KrisKraa/OpenAQUA/hardware/main-controller/r2/pcb_preview/copper_top_bottom.png

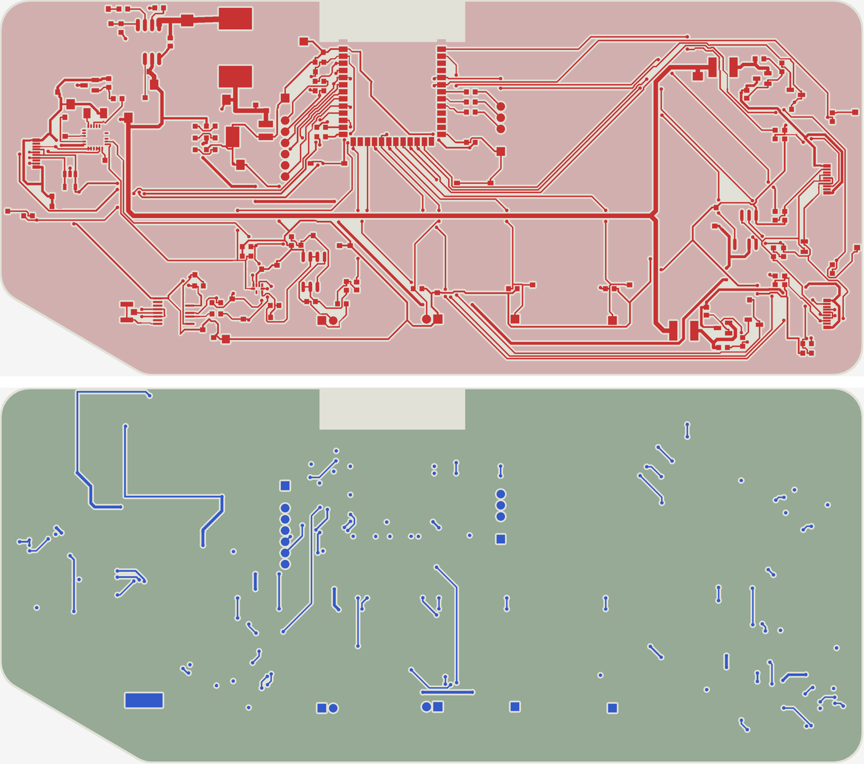
hardware/main-controller/r2/pcb_preview/copper_top_bottom.png
