KrisKraa/OpenAQUA/hardware/main-controller/r2/sch_preview/buck_ldo.png

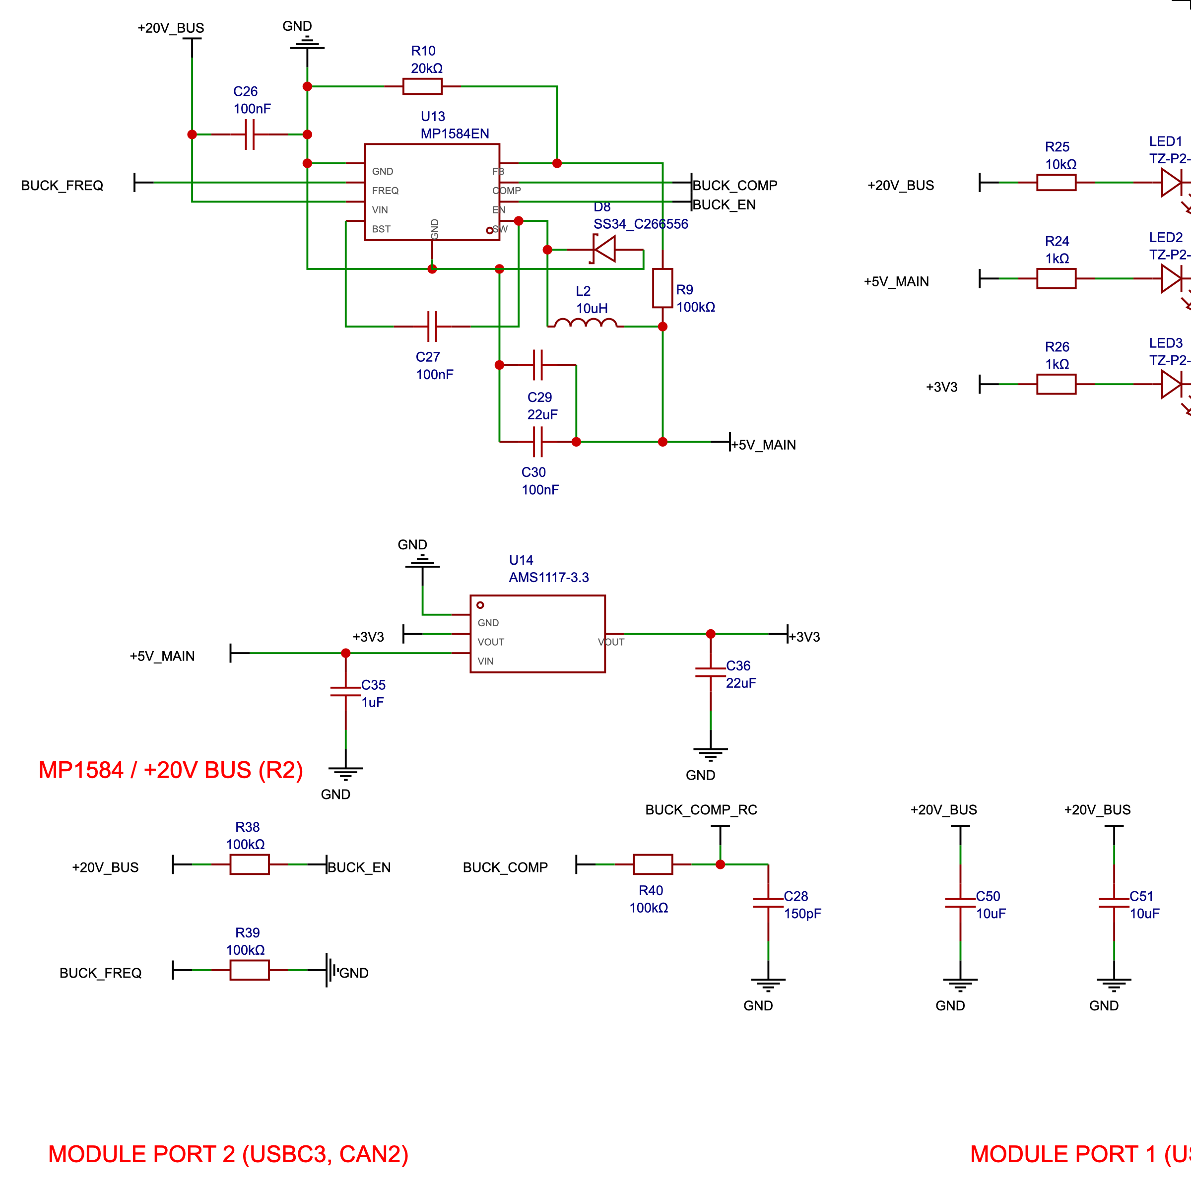
hardware/main-controller/r2/sch_preview/buck_ldo.png
