KrisKraa/OpenAQUA/hardware/main-controller/r2/sch_preview/can_usbc.png

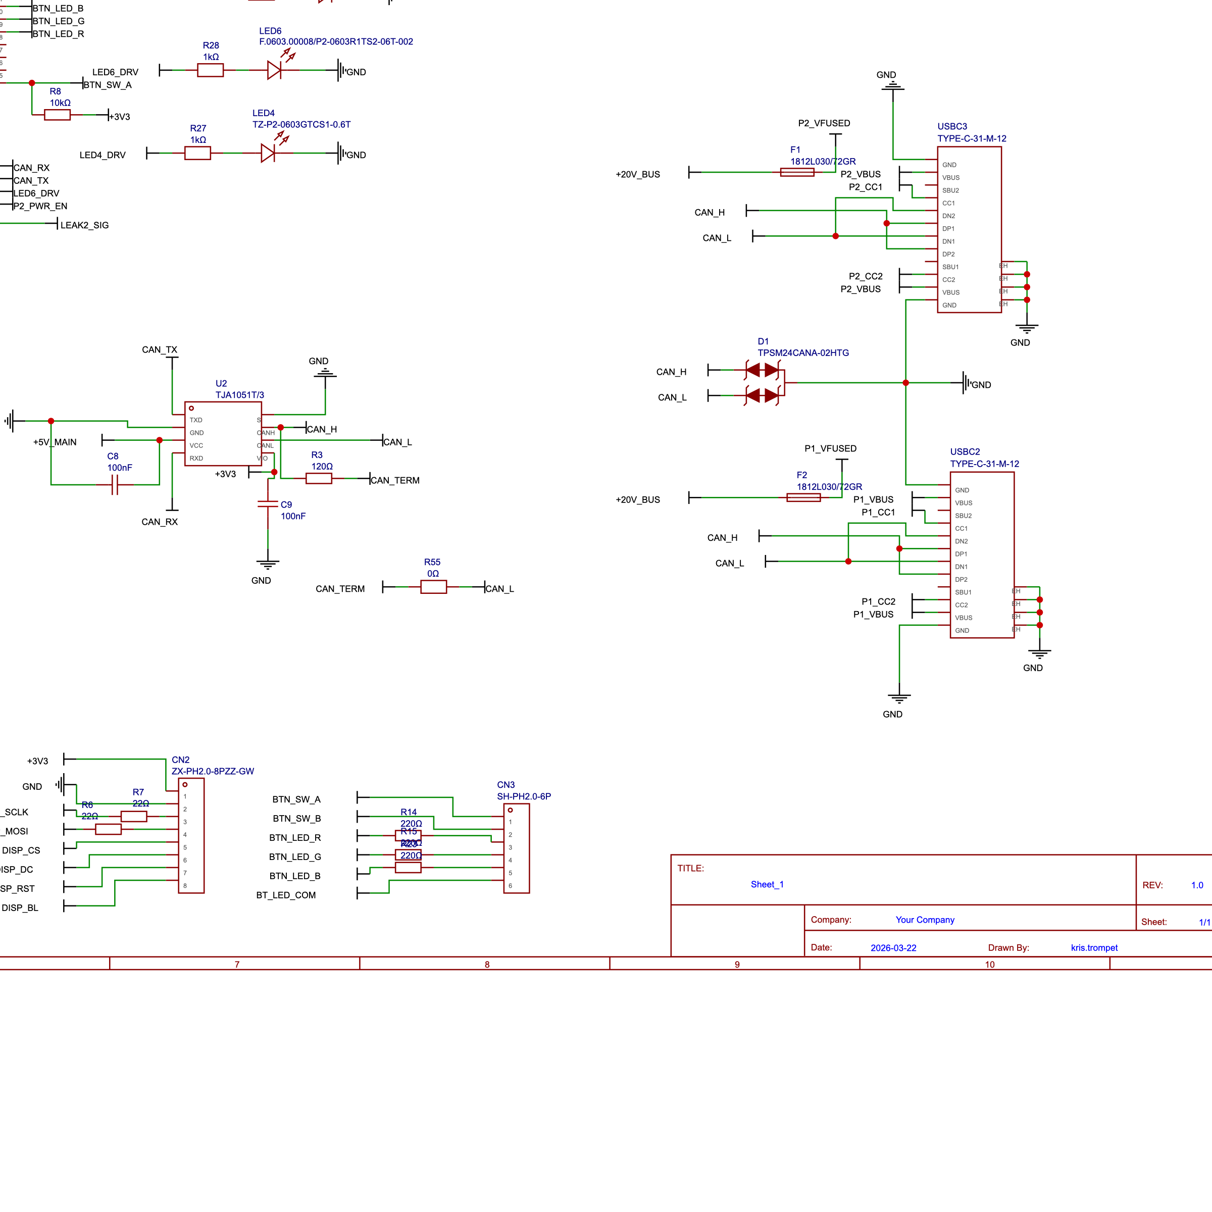
hardware/main-controller/r2/sch_preview/can_usbc.png
