KrisKraa/OpenAQUA/hardware/main-controller/r2/sch_preview/ports.png

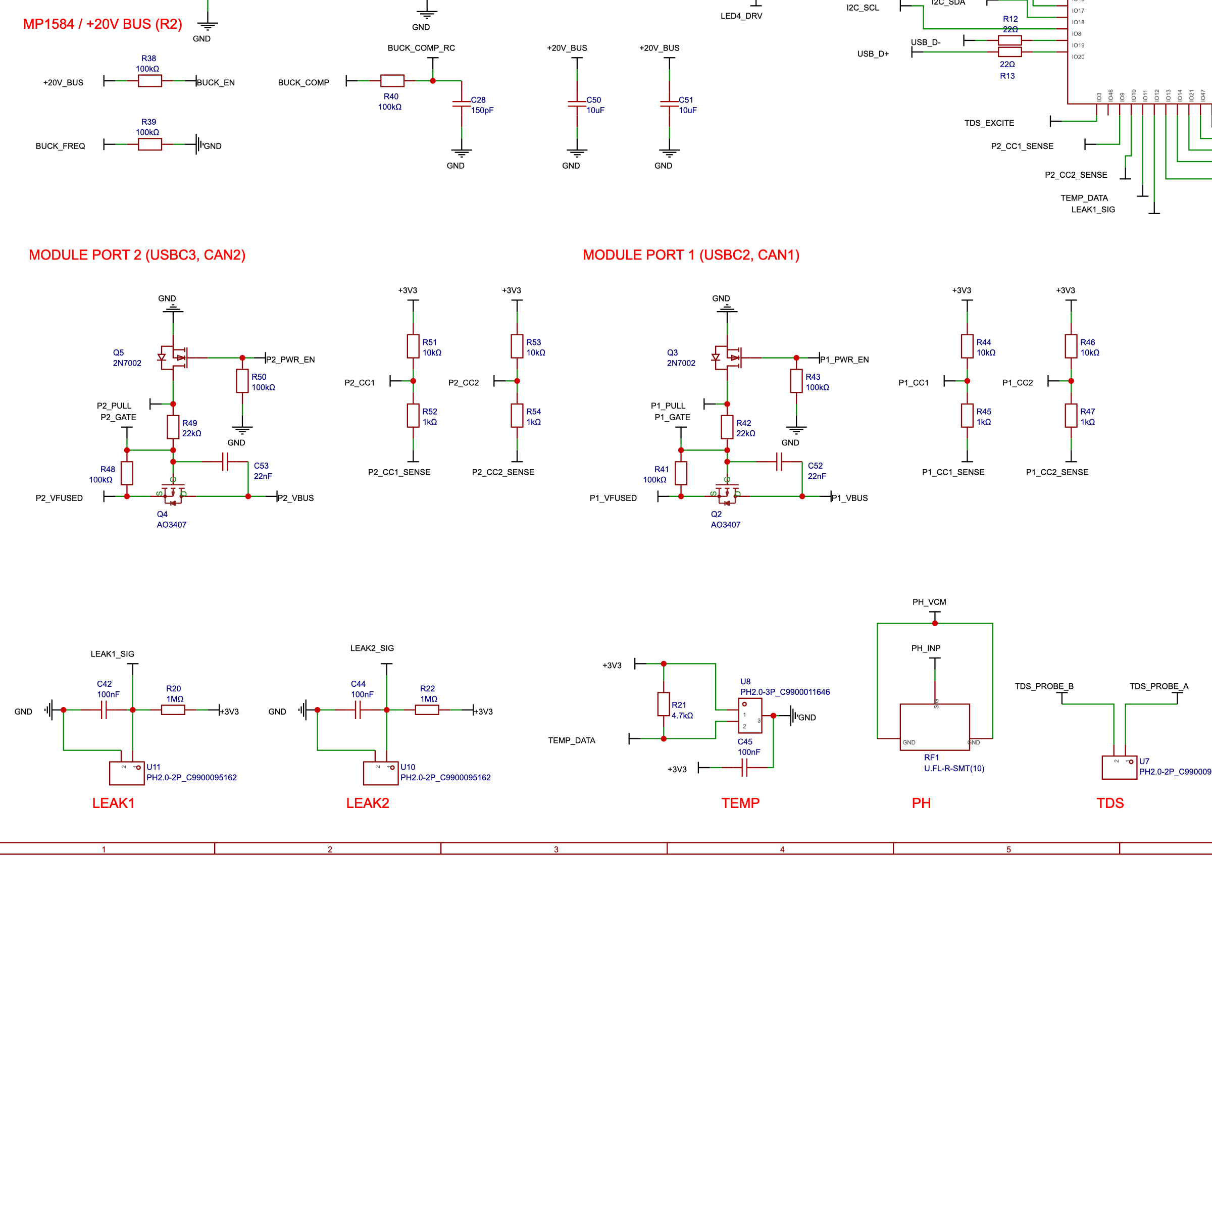
hardware/main-controller/r2/sch_preview/ports.png
