KrisKraa/OpenAQUA/hardware/main-controller/r2/sch_preview/stusb_esp_top.png

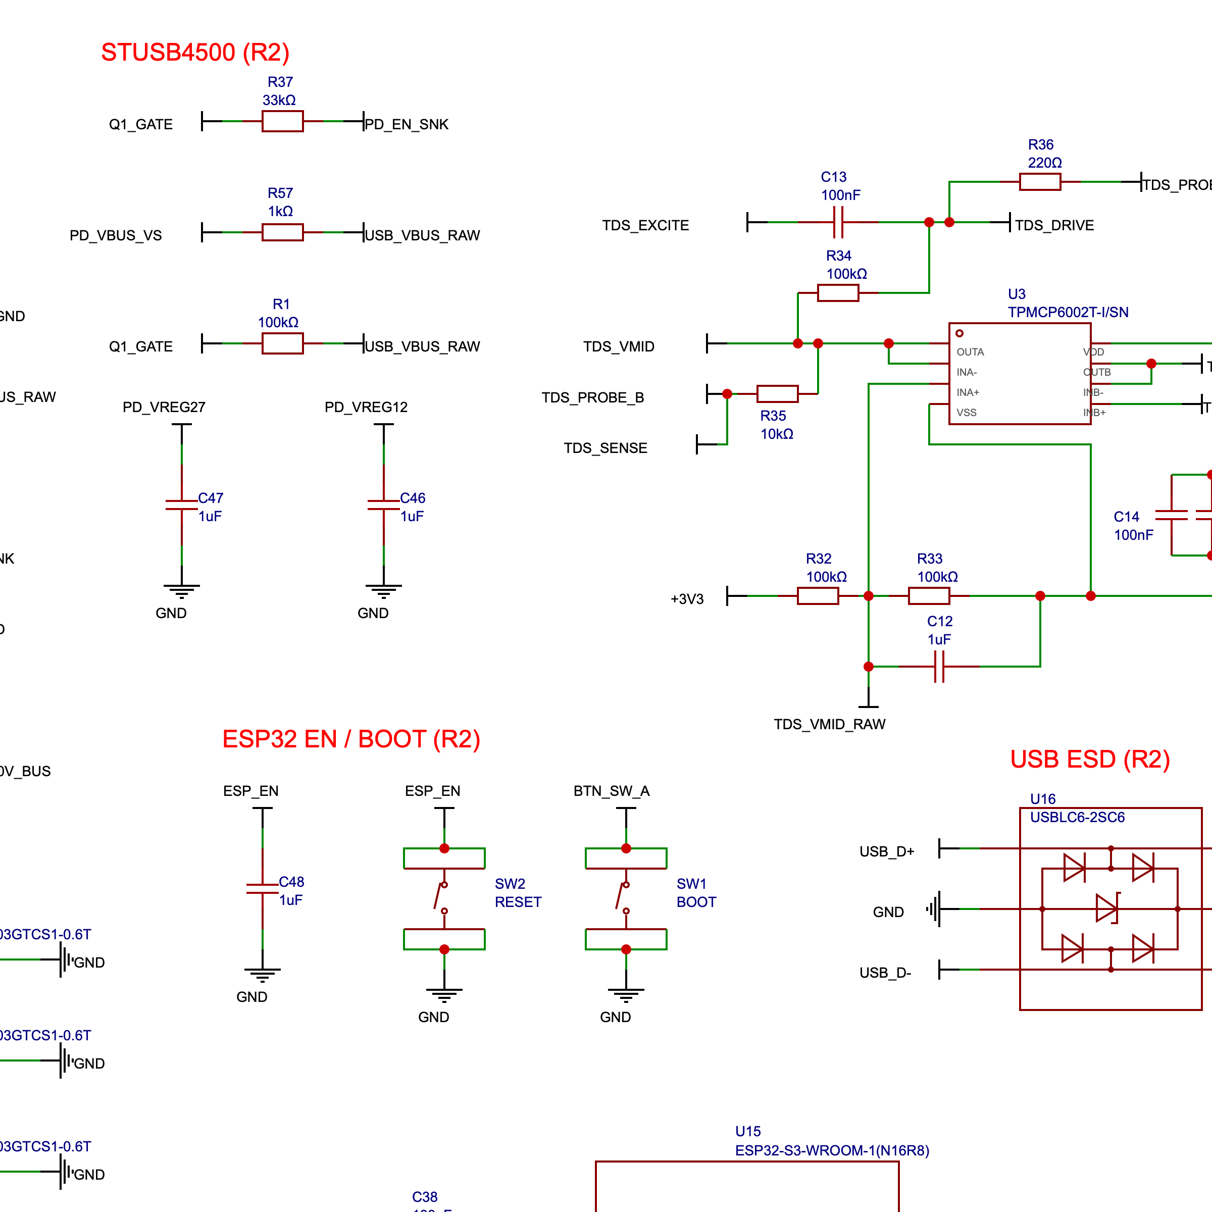
hardware/main-controller/r2/sch_preview/stusb_esp_top.png
