KrisKraa/OpenAQUA/mechanical/Main Controller.step

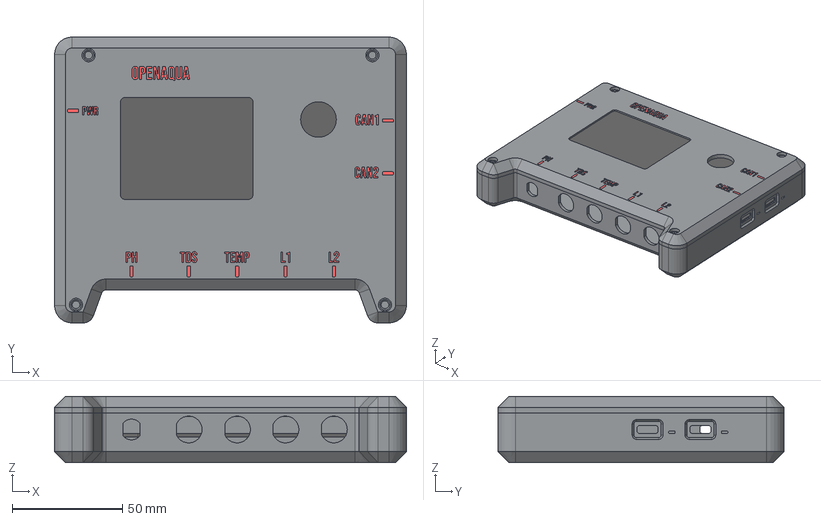
[picture p9: CAD file, 2026-10-19]
mechanical/Main Controller.step
160.0 x 130.0 x 30.0 mm
