KrisKraa/OpenAQUA/(list of files, drawings)

Other design files:
hardware/main-controller/original/PCB_PCB_Aquacontrol_2026-10-08.json
hardware/main-controller/r2/PCB_OpenAQUA_R2.json
SCH_Aquacontrol_2026-05-27.json
