KrisKraa/OpenAQUA/(commit log)

2026-05-27 Added my easyeda file
    This file is the first mockup of what needs to be on the main controller
    [SCH_Aquacontrol_2026-05-27.json]
2026-10-19 Move original schematic to hardware/main-controller/original, add PCB (2026-10-08) and enclosure STEP
2026-10-19 R2: electrical fixes as data (r2_changes.py) + EasyEDA PCB/DSN tooling
    Fixes STUSB4500 power-up (VDD, dead-battery CC, RESET polarity, VREG caps, EP),
    MP1584 (catch diode orientation, EN, FREQ, COMP), USB data to ESP32 + ESD,
    LMP91200 VCM/VREF/VOCM wiring, cap voltage ratings, LED4 polarity,
    switched + CC-detected module ports, CAN termination jumper.
2026-10-19 R2: review fixes (TJA1051, AMS1117, VBUS_VS_DISCH R, 1-Wire cap, leak pull-ups, soft-start, BOOT/RESET) + placement
2026-10-19 R2: routing pipeline (Freerouting two-stage), verifier, finishing step; docs from review
2026-10-19 R2 schematic (EasyEDA Std JSON) built from r2_changes.py; pin-level match with the PCB netlist
2026-10-19 R2 PCB routed: hand-routed power/analog/USB, Freerouting for the rest, pours + stitching; final check passes
2026-10-19 R2: JLCPCB-ready DRC rules, min track 0.15 mm, standard vias; ordering steps
2026-10-19 R2: stitching vias keep clear of existing holes (fixes 15 EasyEDA DRC errors); hole + exact clearance checks
2026-10-19 R2: fixes for EasyEDA DRC (USB-C peg holes as obstacles, footprint header flag, thermal spokes, ESP32 corner GND ties), readable silkscreen + logo placement; EasyEDA DRC 0 errors, 119/119 nets
2026-10-19 R2 BOM: JLCPCB Basic / in-stock equivalents (66 parts; extended part types 45 -> 21), real JST PH connectors, stocked MP1584EN listing, LEDs with matching pin-1 polarity
2026-10-19 R2 PCB: switch off unused Inner1/Inner2 layers (2-layer stack-up)
2026-10-19 R2 BOM: LED1-4 -> XL-0603QYGC (C2289, pin1 = cathode); C72043 out of stock
2026-10-19 Bring-up firmware for R2 + Wokwi simulation (ESP32-S3, display, RGB button, LEDs, DS18B20, leak, simulated ADS1115 custom chip, module-port detection)
2026-10-19 Wokwi sim tested: fix CC reading, leak switch default, ADC scale; redraw only changed lines
    - firmware: draw only display lines that changed (full redraw blocked loop() and delayed
    port switch-off / button); CC voltage read via raw analogRead in SIMULATION builds
    - diagram: leak switches default to dry
    - ads1115 chip: rescale Wokwi's 5 V analog scale to 3.3 V
    - README: what was tested and the simulator quirks
2026-10-19 R2 PCB: OpenAQUA_R2 and OTG silkscreen in the stroke font (TrueType outline was lost, drew as a 1 mm blob)
2026-10-19 R2 PCB: board name 1.6 mm and 1 mm left so it clears the top-right mounting hole
2026-10-19 README: R2 renders (board 3D, case), high-res schematic, review request; R1 images kept for comparison; docs no longer say the layout is unfinished
